gashel01/agentpad/hardware/case/v2_bloc_plaque/07_halo_left_couvercle.stl

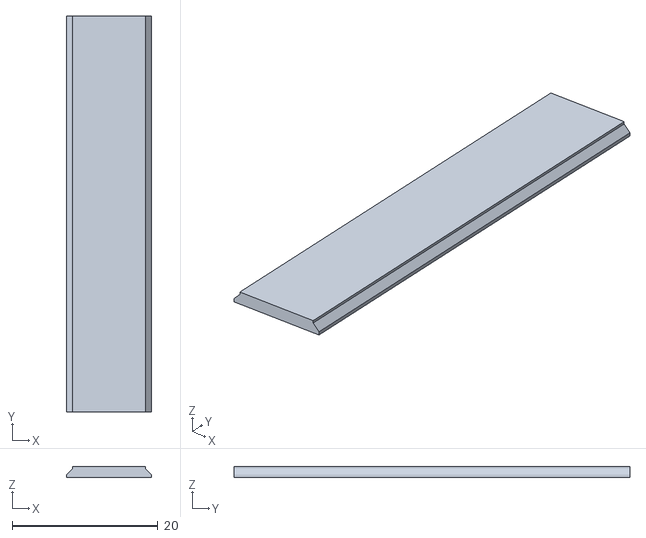
[picture p10: CAD file, 2026-10-17]
hardware/case/v2_bloc_plaque/07_halo_left_couvercle.stl
11.6 x 54.3 x 1.50
