gashel01/agentpad/hardware/case/v2_diffuseur/14_diffuseur_anneau.stl

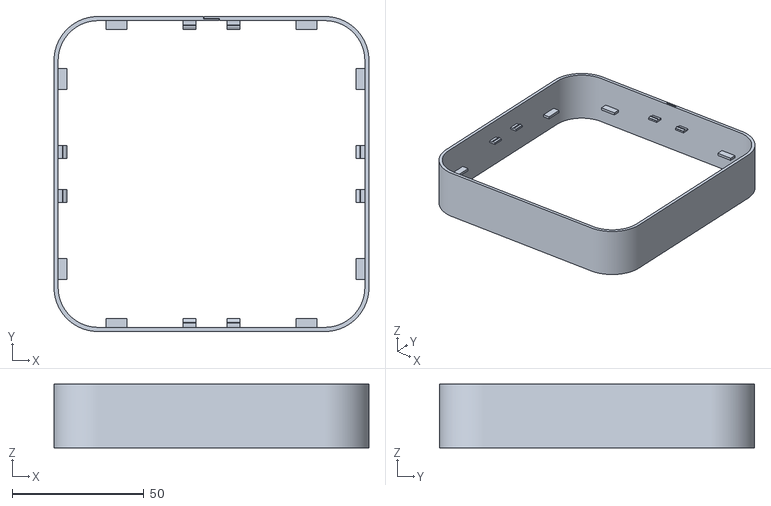
[picture p11: CAD file, 2026-10-17]
hardware/case/v2_diffuseur/14_diffuseur_anneau.stl
119.4 x 119.4 x 24.2
