gashel01/agentpad/hardware/case/v2_fond/11_trappe_fond_clipsee.stl

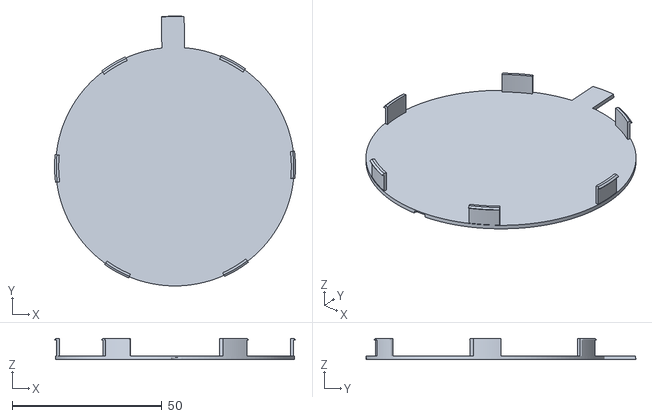
[picture p12: CAD file, 2026-10-17]
hardware/case/v2_fond/11_trappe_fond_clipsee.stl
80.4 x 90.0 x 7.15
