gashel01/agentpad/hardware/case/v2_keycaps/04_agent_4.stl

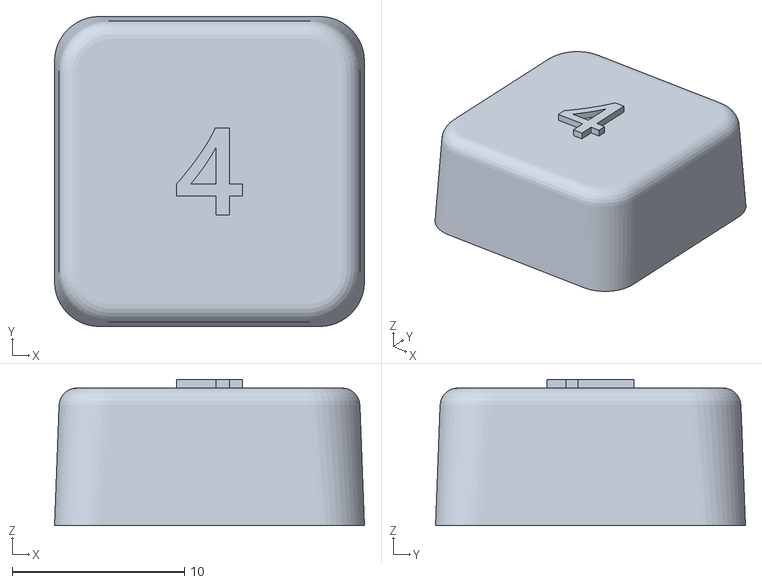
[picture p13: CAD file, 2026-10-17]
hardware/case/v2_keycaps/04_agent_4.stl
18.0 x 18.0 x 8.50
