gashel01/agentpad/hardware/case/v2_bloc_plaque/01_plaque_dessus.stl

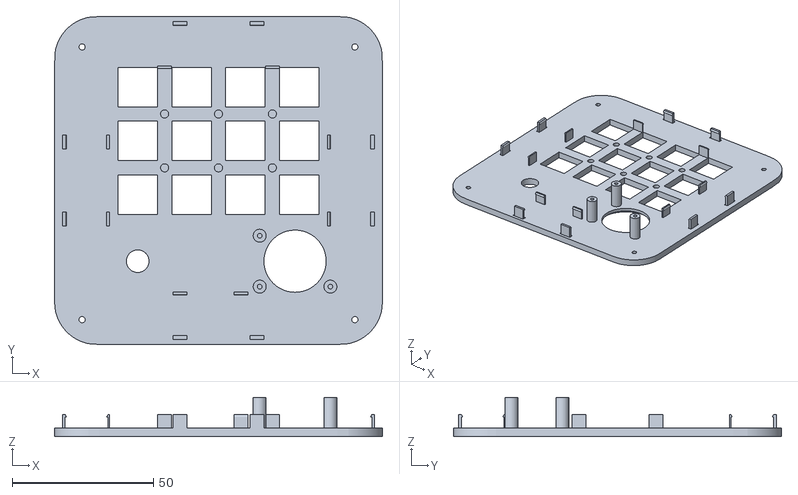
[picture p14: CAD file, 2026-10-17]
hardware/case/v2_bloc_plaque/01_plaque_dessus.stl
116.0 x 116.0 x 13.9
