gashel01/agentpad/hardware/case/v2_fond/10_fond_boitier_base.stl

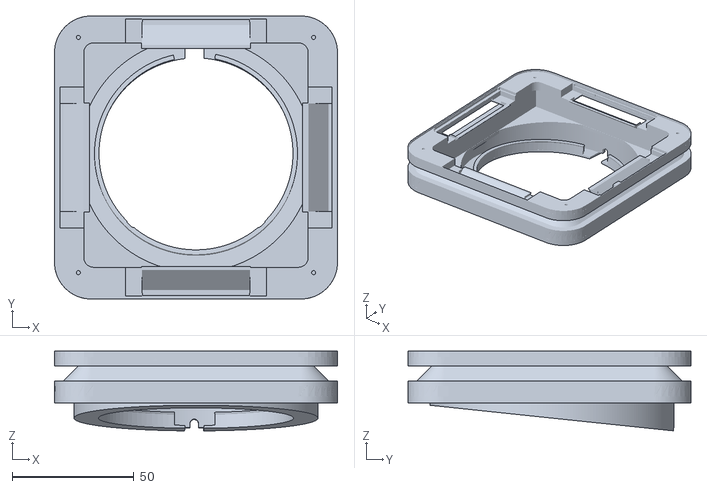
[picture p15: CAD file, 2026-10-17]
hardware/case/v2_fond/10_fond_boitier_base.stl
116.0 x 116.0 x 32.7
