gashel01/agentpad/hardware/case/v2_keycaps/07_agent_7.stl

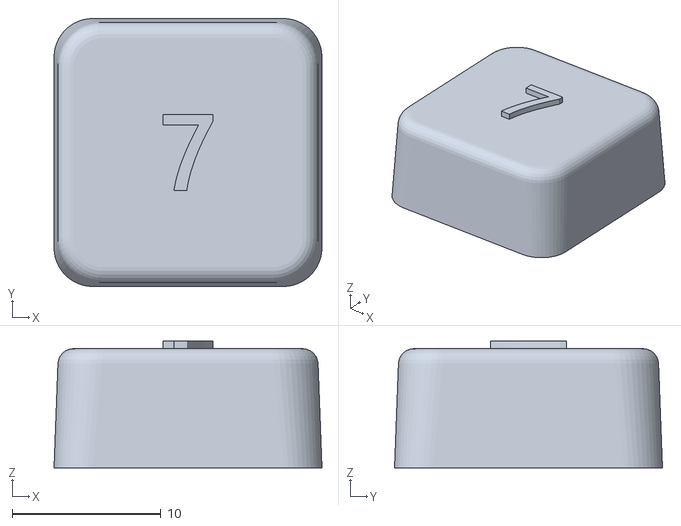
[picture p16: CAD file, 2026-10-17]
hardware/case/v2_keycaps/07_agent_7.stl
18.0 x 18.0 x 8.50
