gashel01/agentpad/hardware/case/v2_bloc_plaque/05_matrice_couvercle_rang2.stl

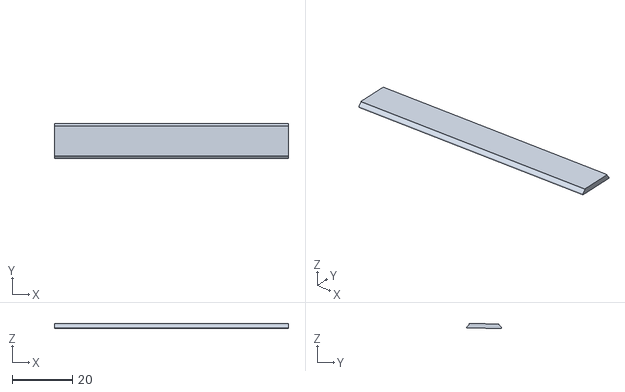
[picture p17: CAD file, 2026-10-17]
hardware/case/v2_bloc_plaque/05_matrice_couvercle_rang2.stl
78.0 x 11.6 x 1.50
