gashel01/agentpad/hardware/case/v2_keycaps/21_check.stl

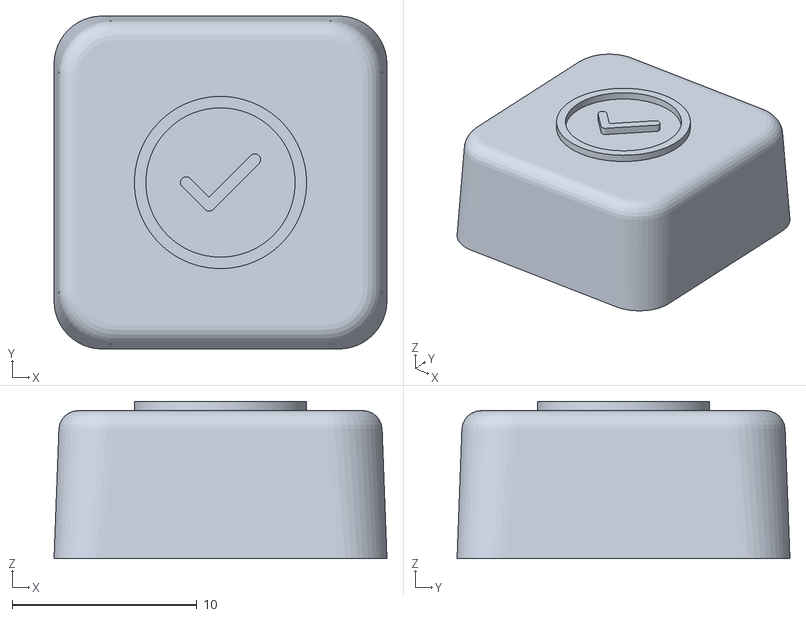
[picture p18: CAD file, 2026-10-17]
hardware/case/v2_keycaps/21_check.stl
18.0 x 18.0 x 8.50
