gashel01/agentpad/hardware/case/v2_bloc_plaque/09_capuchon_joystick.stl

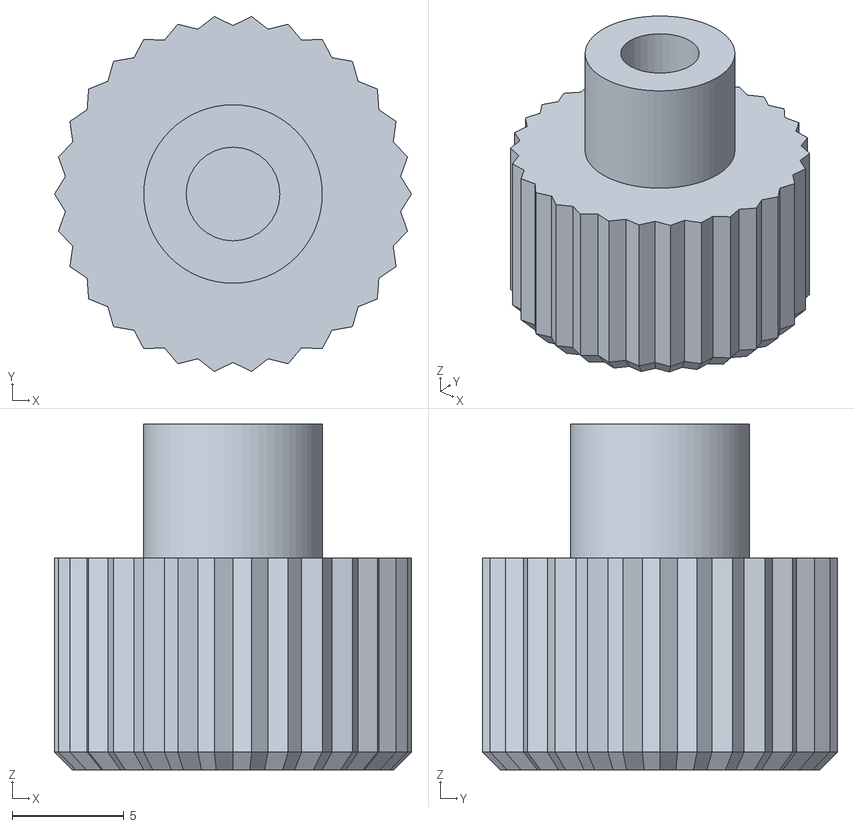
[picture p19: CAD file, 2026-10-17]
hardware/case/v2_bloc_plaque/09_capuchon_joystick.stl
16.0 x 15.9 x 15.5
