gashel01/agentpad/hardware/case/v2_bloc_plaque/06_halo_back_bloc.stl

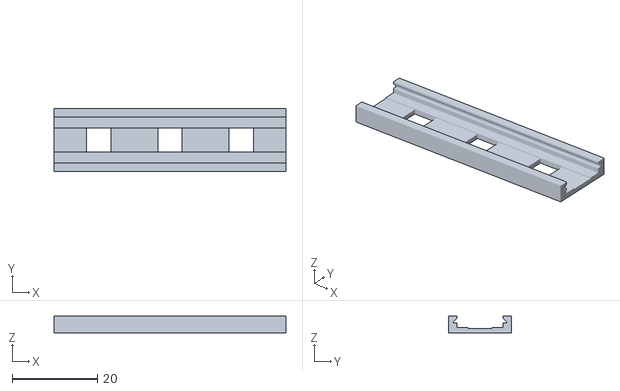
[picture p20: CAD file, 2026-10-17]
hardware/case/v2_bloc_plaque/06_halo_back_bloc.stl
54.3 x 14.7 x 3.90
