gashel01/agentpad/hardware/case/v2_bloc_plaque/08_knob.stl

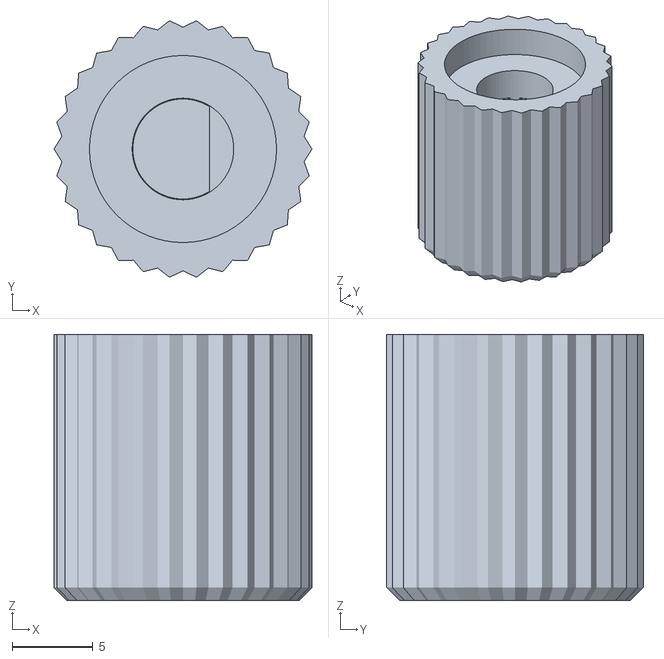
[picture p21: CAD file, 2026-10-17]
hardware/case/v2_bloc_plaque/08_knob.stl
16.0 x 15.9 x 16.5
