gashel01/agentpad/hardware/case/v2_bloc_plaque/02_grille_A_rangees.stl

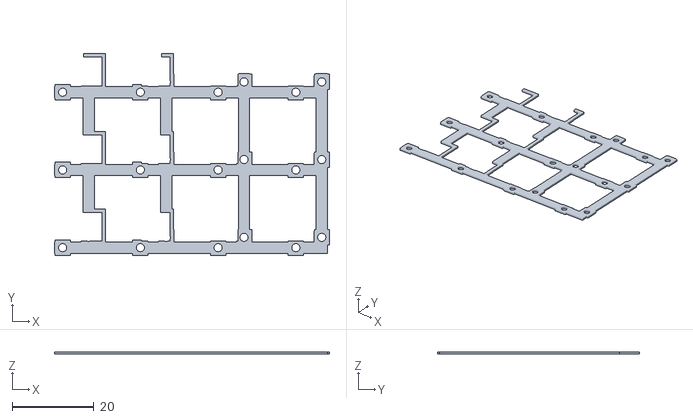
[picture p22: CAD file, 2026-10-17]
hardware/case/v2_bloc_plaque/02_grille_A_rangees.stl
67.4 x 49.5 x 0.6
