gashel01/agentpad/hardware/case/v2_bloc_plaque/05_matrice_couvercle_rang1.stl

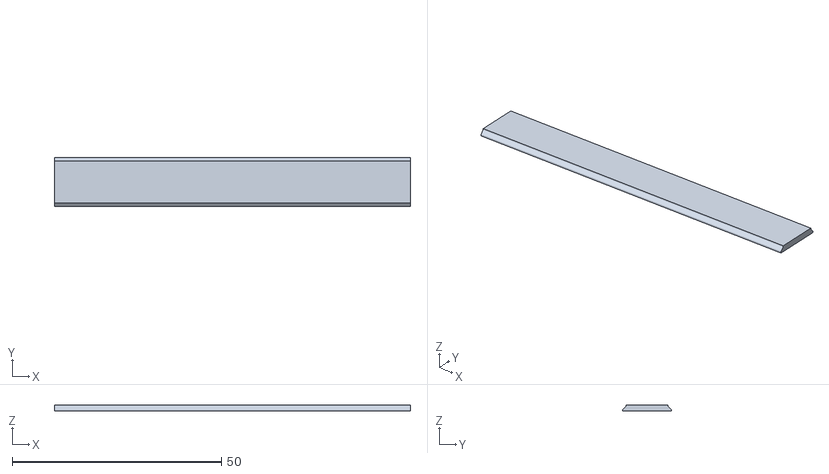
[picture p23: CAD file, 2026-10-17]
hardware/case/v2_bloc_plaque/05_matrice_couvercle_rang1.stl
85.0 x 11.6 x 1.50
