gashel01/agentpad/hardware/case/v2_bloc_plaque/03_grille_B_colonnes.stl

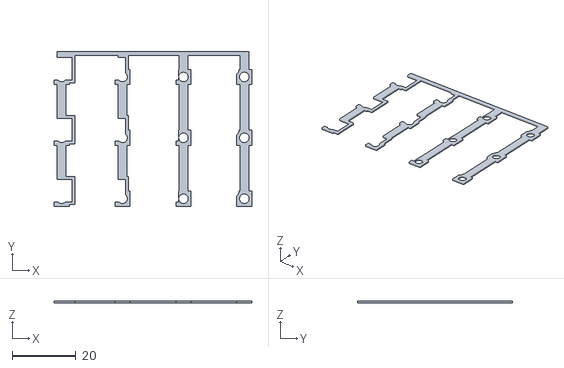
[picture p24: CAD file, 2026-10-17]
hardware/case/v2_bloc_plaque/03_grille_B_colonnes.stl
62.0 x 48.4 x 0.6
