gashel01/agentpad/hardware/case/v2_keycaps/10_agent_lisse_x8.stl

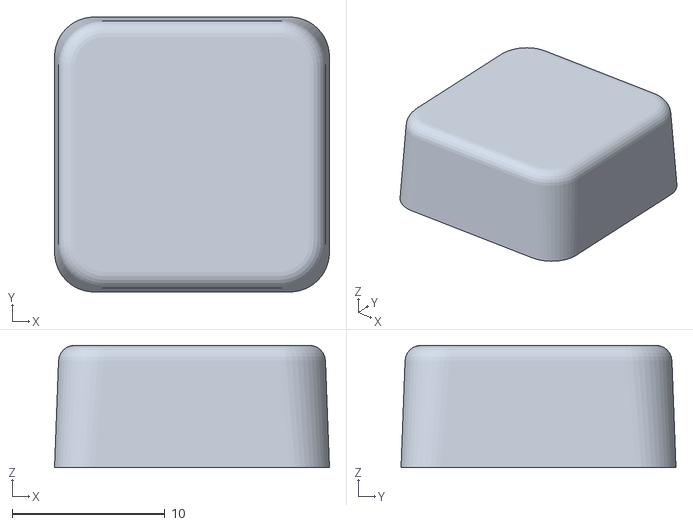
[picture p25: CAD file, 2026-10-17]
hardware/case/v2_keycaps/10_agent_lisse_x8.stl
18.0 x 18.0 x 8.00
