gashel01/agentpad/hardware/case/v2_bloc_plaque/04_matrice_led.stl

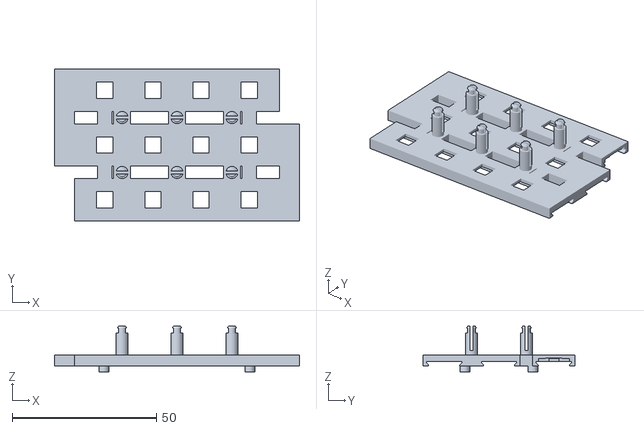
[picture p26: CAD file, 2026-10-17]
hardware/case/v2_bloc_plaque/04_matrice_led.stl
85.0 x 52.8 x 15.9
