gashel01/agentpad/(list of files, cad)

Other CAD files:
hardware/case/v2_bloc_plaque/07_halo_front_couvercle.stl
hardware/case/v2_keycaps/01_agent_1.stl
hardware/case/v2_keycaps/06_agent_6.stl
hardware/case/v2_keycaps/02_agent_2.stl
hardware/case/v2_bloc_plaque/06_halo_front_bloc.stl
hardware/case/v2_keycaps/03_agent_3.stl
hardware/case/v2_keycaps/23_micro.stl
hardware/case/v2_bloc_plaque/06_halo_left_bloc.stl
hardware/case/v2_keycaps/05_agent_5.stl
hardware/case/v2_bloc_plaque/07_halo_back_couvercle.stl
hardware/case/v2_keycaps/08_agent_8.stl
hardware/case/v2_keycaps/20_eclair.stl
hardware/case/v2_keycaps/22_croix.stl
hardware/case/v2_bloc_plaque/05_matrice_couvercle_rang0.stl
hardware/case/v2_bloc_plaque/06_halo_right_bloc.stl
hardware/case/v2_bloc_plaque/07_halo_right_couvercle.stl
