gashel01/agentpad/(commit log)

2026-10-17 agentpad: a physical pad for Claude Code agent sessions
    ESP32 firmware (key matrix, knob, joystick, 24 RGBW LEDs, JSON over USB serial),
    host software for Windows and macOS (3D control page, radial menu, session tracking
    and hooks, macro profiles, tests) and the v2 case (final STL files, keycap generator).
    [01_agent_1.stl, 01_plaque_dessus.stl, 02_agent_2.stl, 02_grille_A_rangees.stl, 03_agent_3.stl, 03_grille_B_colonnes.stl, 04_agent_4.stl, 04_matrice_led.stl]
2026-10-17 Start with the computer: agentpad runs in the background at login
    Advanced > Start with the computer in the page, or agentpad-autostart on|off.
    Windows: per-user Run entry (pythonw, no console). macOS: LaunchAgent. Linux: XDG autostart.
    --background skips the browser tab and logs to ~/.agentpad/agentpad.log; launching
    agentpad-gui while it already runs just opens the page.
    [autostart.py, test_autostart.py]
2026-10-17 Tray icon, headless claude runs ignored, halo diffuser published
    - Notification-area icon: click opens the page, right-click shows the pad
    connection and quits (LEDs off, radial menu closed).
    - claude -p / --print runs (other apps driving Claude in the background) no
    longer take an agent key: only real terminal sessions do.
    - The one-piece halo diffuser is validated: STL published, case docs updated.
    [14_diffuseur_anneau.stl]
2026-10-17 3D preview shows the live LEDs
    LED values are PWM, i.e. linear light output: they were decoded as sRGB, which
    crushed a key at 34 % to ~9 % and left the whole preview white. Read them as
    linear light with a perceptual curve, so lit and breathing keys show as on the pad.
2026-10-30 Pad port: never a Bluetooth link, ping for hello, Disconnect fixed
    - Auto-detection no longer falls back to any port: at login the pad's USB port can
    appear after the Bluetooth ones, and the software stayed connected to a Bluetooth
    link that is not the pad.
    - A ping is sent on connect; an auto-picked port that never says hello is dropped.
    - Disconnect was sent as a GET (405); picking another port while connected now
    switches to it. The port list puts the pad first and flags Bluetooth links.
    [serial_link.py, test_ports.py]
2026-11-01 Ignore the Claude desktop app: only Claude Code sessions get a key
    The desktop app is also called claude.exe and, being Electron, runs a main process
    plus renderer, GPU, network and audio children. Each one took an agent key (11 keys
    lit for 2 sessions). Processes with an Electron --type= argument or living in the
    desktop app's install folder (Windows Store, AnthropicClaude, Claude.app) are skipped.
    [agent_sessions.py, test_agent_keys.py]
